albachten/MiniSlat/v1.0/MiniSlat.pdf

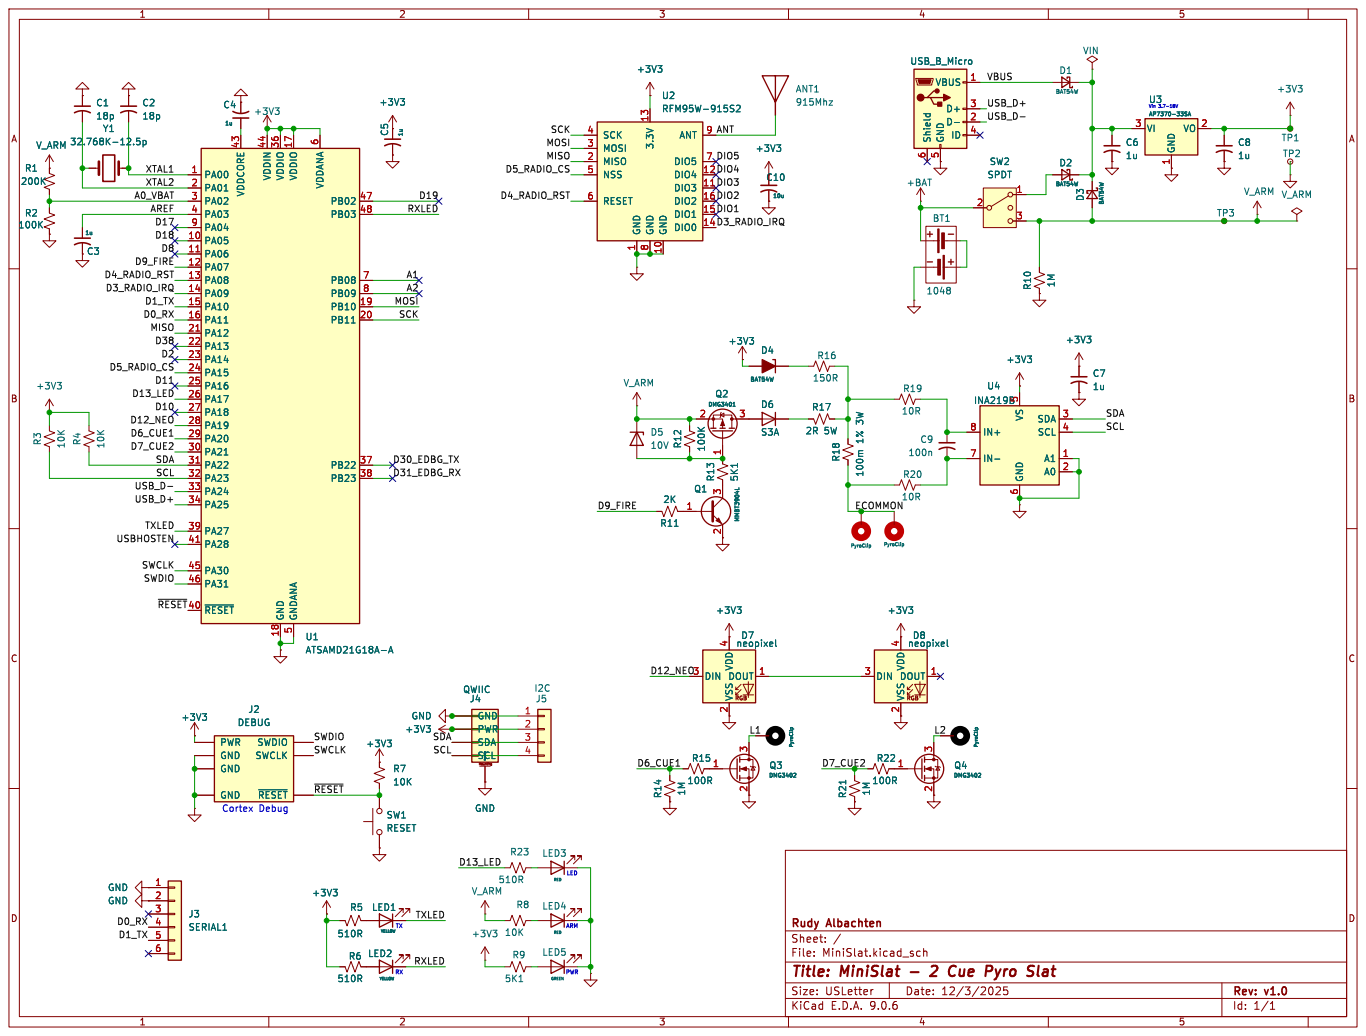
[picture p2: page 1]

2 DOUT 1 +3V3 Q1 MMBT3904L 1
Id: 1/1 Title: MiniSlat - 2 Cue Pyro Slat File: MiniSlat.kicad_sch Sheet: / Rudy Albachten R11

~{RESET} J2 DEBUG
PWR GND GND GND

J2 DEBUG
