albachten/MiniSlat/MiniSlat.kicad_pcb

## KiCad design MiniSlat.kicad_pcb (2026-10-15)

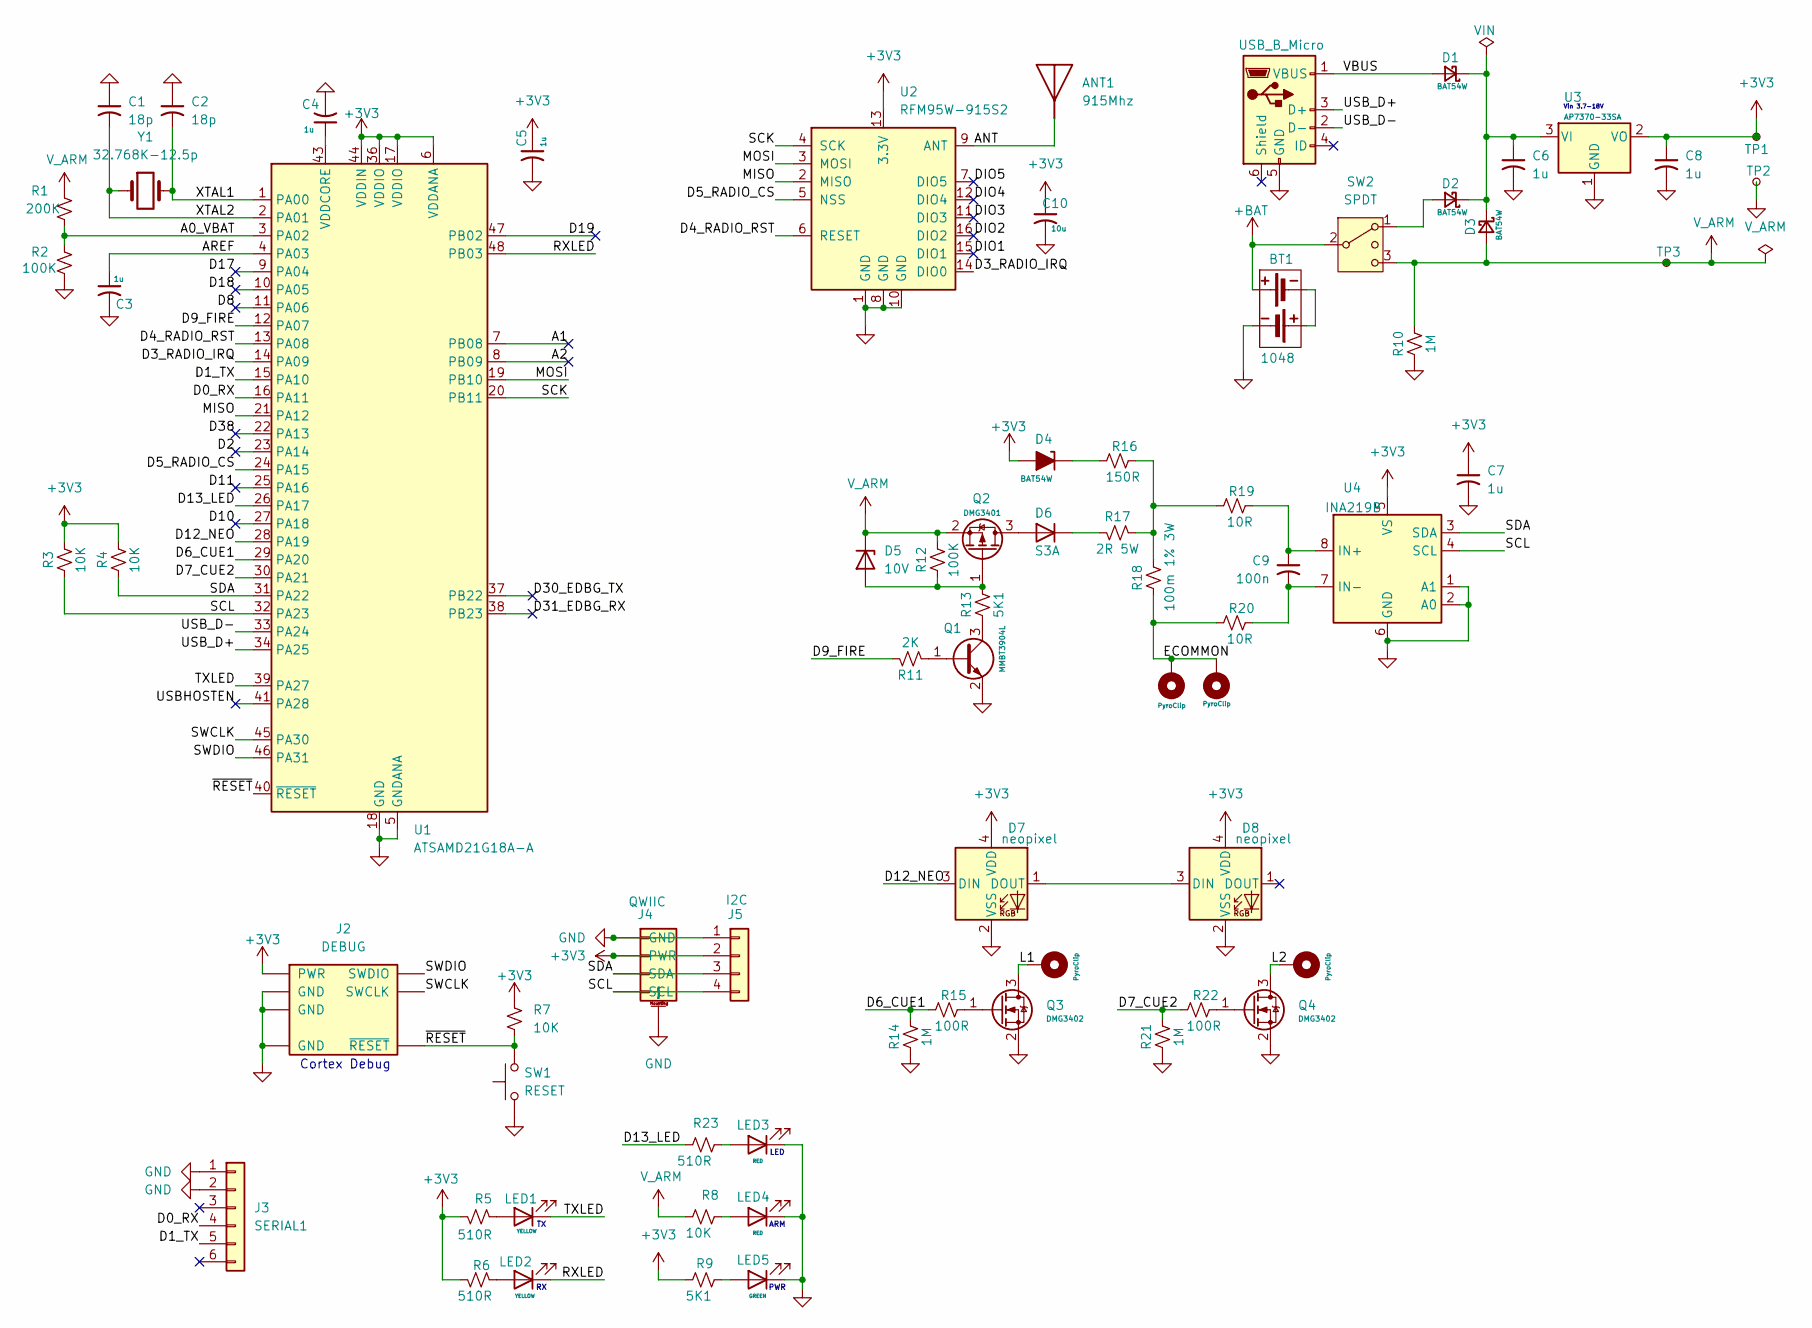
[picture p3: schematic MiniSlat.kicad_sch, MiniSlat - 2 Cue Pyro Slat]

Parts:
ANT1: 915Mhz; Antenna915MHzSimpleCoil; Manufacturer_Part_Number 4269; Mouser_Part_Number 485-4269
BT1: 1048; BAT_1048P
C1, C2: 18p; C_0603_1608Metric
C3, C4, C5, C6, C7, C8: 1u; C_0603_1608Metric
C9: 100n; C_0603_1608Metric
C10: 10u; C_0603_1608Metric
CLIP1, CLIP3: PyroClip; PyroClipRed; Mouser_Part_Number N/A
CLIP2, CLIP4: PyroClip; PyroClipBlack; Mouser_Part_Number N/A
D1, D2, D3, D4: BAT54W; D_SOD-123; Mouser_Part_Number 78-BAT54W-HG3-18
D5: 10V; SOT-23; Mouser_Part_Number 863-BZX84C10LT1G
D6: S3A; D_SMC; Mouser_Part_Number 512-S3A
D7, D8: neopixel; LED_WS2812B-2020_PLCC4_2.0x2.0mm
J1: USB_B_Micro; USB_Micro-B_Amphenol_10118194_Horizontal; Mouser_Part_Number 649-10118194-0011LF
J2: DEBUG; CortexDebugSMD; Mouser_Part_Number 640-BD12510A305580LB
J3: SERIAL1; PinHeader_1x06_P2.54mm_Vertical
J4: QWIIC; QWIIC_JST_SH_BM04B-SRSS-TB_1x04-1MP_P1.00mm_Vertical
J5: I2C; PinHeader_1x04_P2.54mm_Vertical
LED1, LED2: YELLOW; LED_0805_2012Metric; Mouser_Part_Number 710-150080YS75000
LED3, LED4: RED; LED_0805_2012Metric; Mouser_Part_Number 710-150080RS75000
LED5: GREEN; LED_0805_2012Metric; Mouser_Part_Number 710-150080RS75000
Q1: MMBT3904L; SOT-23; Mouser_Part_Number 771-MMBT3904VL
Q2: DMG3401; SC-59; Mouser_Part_Number 621-DMP3099L-13
Q3, Q4: DMG3402; SOT-23; Mouser_Part_Number 621-DMG3402L-7
R1: 200K; R_0603_1608Metric
R2, R12: 100K; R_0603_1608Metric
R3, R4, R7, R8: 10K; R_0603_1608Metric
R5, R6, R23: 510R; R_0603_1608Metric
R9, R13: 5K1; R_0603_1608Metric
R10, R14, R21: 1M; R_0603_1608Metric
R11: 2K; R_0603_1608Metric
R15, R22: 100R; R_0603_1608Metric
R16: 150R; R_0603_1608Metric
R17: 2R 5W; R_Axial_Power_L25.0mm_W6.4mm_P27.94mm; Mouser_Part_Number 588-TUW5J2R0E
R18: 100m 1% 3W; R_2512_6332Metric
R19, R20: 10R; R_0603_1608Metric
SW1: RESET; TL3305B_SPST_PushButton; Mouser_Part_Number 652-CR0805JW-104ELF
SW2: SPDT; spdt_100SP1T1B2M2QE
TP1, TP2, TP3: RCTCTE; Mouser_Part_Number 660-RCTCTE
U1: ATSAMD21G18A-A; TQFP-48_7x7mm_P0.5mm; Mouser_Part_Number 556-ATSAMD21G18A-MU
U2: RFM95W-915S2; RFM95CW; Mouser_Part_Number 223-RFM95W-915S2
U3: AP7370-33SA; TSOT-23
U4: INA219B; SOIC-8_3.9x4.9mm_P1.27mm; Mouser_Part_Number 595-INA219BIDR
Y1: 32.768K-12.5p; Crystal_SMD_G8-2Pin_3.2x1.5mm; Mouser_Part_Number 520-327-12.5-34B

Connections:
+3V3: C5.1, C7.1, C8.1, C10.1, D4.2 (A), D7.4 (VDD), D8.4 (VDD), J2.1 (PWR), J4.2 (PWR), J5.2, R3.2, R4.2, R5.1, R6.1, R7.2, R9.1, TP1.1, U1.6 (VDDANA), U1.17 (VDDIO), U1.36 (VDDIO), U1.44 (VDDIN), U2.13 (3.3V), U3.2 (VO), U4.5 (VS)
+BAT: BT1.1, SW2.2 (3)
/A0_VBAT: R1.2, R2.1, U1.3 (PA02)
/A1: U1.7 (PB08)
/A2: U1.8 (PB09)
/ANT: ANT1.1 (A), U2.9 (ANT)
/AREF: C3.1, U1.4 (PA03)
/D0_RX: J3.4, U1.16 (PA11)
/D1_TX: J3.5, U1.15 (PA10)
/D2: U1.23 (PA14)
/D3_RADIO_IRQ: U1.14 (PA09), U2.14 (DIO0)
/D4_RADIO_RST: U1.13 (PA08), U2.6 (RESET)
/D5_RADIO_CS: U1.24 (PA15), U2.5 (NSS)
/D6_CUE1: R14.2, R15.1, U1.29 (PA20)
/D7_CUE2: R21.2, R22.1, U1.30 (PA21)
/D8: U1.11 (PA06)
/D9_FIRE: R11.1, U1.12 (PA07)
/D10: U1.27 (PA18)
/D11: U1.25 (PA16)
/D12_NEO: D7.3 (DIN), U1.28 (PA19)
/D13_LED: R23.1, U1.26 (PA17)
/D17: U1.9 (PA04)
/D18: U1.10 (PA05)
/D19: U1.47 (PB02)
/D30_EDBG_TX: U1.37 (PB22)
/D31_EDBG_RX: U1.38 (PB23)
/D39: U1.22 (PA13)
/DIO1: U2.15 (DIO1)
/DIO2: U2.16 (DIO2)
/DIO3: U2.11 (DIO3)
/DIO4: U2.12 (DIO4)
/DIO5: U2.7 (DIO5)
/ECOMMON: CLIP1.1, CLIP3.1, R18.1, R20.1
/L1: CLIP2.1, Q3.3 (D)
/L2: CLIP4.1, Q4.3 (D)
/MISO: U1.21 (PA12), U2.2 (MISO)
/MOSI: U1.19 (PB10), U2.3 (MOSI)
/RXLED: LED2.1 (K), U1.48 (PB03)
/SCK: U1.20 (PB11), U2.4 (SCK)
/SCL: J4.4 (SCL), J5.4, R3.1, U1.32 (PA23), U4.4 (SCL)
/SDA: J4.3 (SDA), J5.3, R4.1, U1.31 (PA22), U4.3 (SDA)
/SWCLK: J2.4 (SWCLK), U1.45 (PA30)
/SWDIO: J2.2 (SWDIO), U1.46 (PA31)
/TXLED: LED1.1 (K), U1.39 (PA27)
/USBHOSTEN: U1.41 (PA28)
/USB_D+: J1.3 (D+), U1.34 (PA25)
/USB_D-: J1.2 (D-), U1.33 (PA24)
/VBUS: D1.2 (A), J1.1 (VBUS)
/XTAL1: C2.2, U1.1 (PA00), Y1.2
/XTAL2: C1.2, U1.2 (PA01), Y1.1
/~RESET: J2.10 (~RESET), R7.1, SW1.2, U1.40 (~RESET)
GND: BT1.3 (N2), C1.1, C2.1, C3.2, C4.2, C5.2, C6.2, C7.2, C8.2, C10.2, D7.2 (VSS), D8.2 (VSS), J1.5 (GND), J2.3 (GND), J2.5 (GND), J2.9 (GND), J3.1, J3.2, J4.1 (GND), J4.MP (MountPin), J5.1, LED3.1 (K), LED4.1 (K), LED5.1 (K), Q1.2 (E), Q3.2 (S), Q4.2 (S), R2.2, R10.1, R14.1, R21.1, SW1.1, TP2.1, U1.5 (GNDANA), U1.18 (GND), U1.35 (GND), U1.42 (GND), U2.1 (GND), U2.8 (GND), U2.10 (GND), U3.1 (GND), U4.1 (A1), U4.2 (A0), U4.6 (GND)
unnamed: BT1.2 (N1), BT1.4 (P2)
unnamed: C6.1, D1.1 (K), D2.1 (K), D3.1 (K), U3.3 (VI)
unnamed: D2.2 (A), SW2.1
unnamed: D4.1 (K), R16.1
unnamed: D5.1 (A), Q2.1 (G), R12.1, R13.2
unnamed: D6.2 (A), Q2.3 (D)
unnamed: D6.1 (K), R17.2
unnamed: D7.1 (DOUT), D8.3 (DIN)
unnamed: LED1.2 (A), R5.2
unnamed: LED2.2 (A), R6.2
unnamed: LED3.2 (A), R23.2
unnamed: LED4.2 (A), R8.2
unnamed: LED5.2 (A), R9.2
unnamed: Q1.1 (B), R11.2
unnamed: Q1.3 (C), R13.1
unnamed: Q3.1 (G), R15.2
unnamed: Q4.1 (G), R22.2
unnamed: R16.2, R17.1, R18.2, R19.1
unnamed: C4.1, U1.43 (VDDCORE)
unnamed: C9.1, R19.2, U4.8 (IN+)
unnamed: C9.2, R20.2, U4.7 (IN-)
V_ARM: D3.2 (A), D5.3 (K), Q2.2 (S), R1.1, R8.1, R10.2, R12.2, SW2.3 (4), TP3.1

Notes on the sheet:
LED
PWR
ARM
Vin 3.7-18V
Cortex Debug

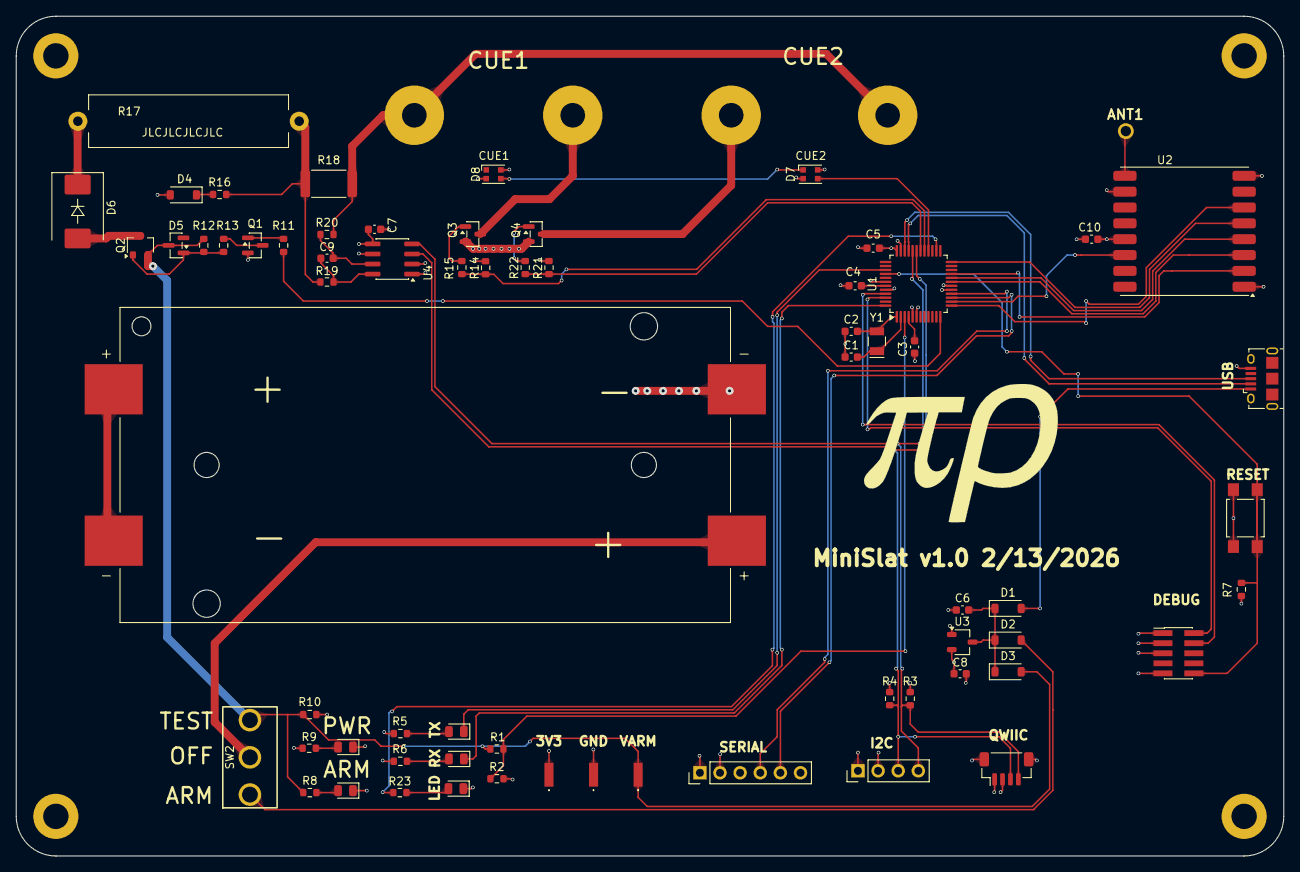
[picture p4: board MiniSlat.kicad_pcb from above]

Board: 4 copper layers, 160.0 x 106.0 mm, 77 parts (1 on the bottom side), 56 nets.

Other parts of the board:
H1, H2, H3, H4: MountingHole_3.2mm_M3_ISO7380_Pad
LOGO1, LOGO2: LOGO; pirho
